CREPP-PLOEMEUR/Cocci-Bot/.img/img.png

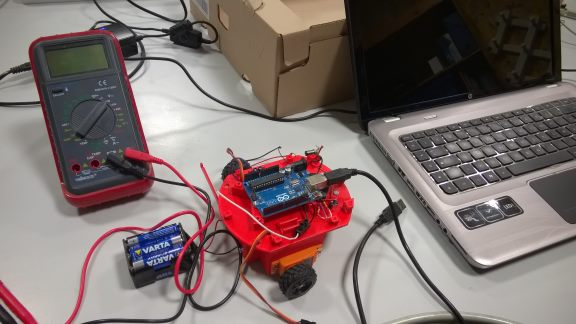
.img/img.png
