CREPP-PLOEMEUR/Cocci-Bot/Images/IMG_20151218_171229.jpg

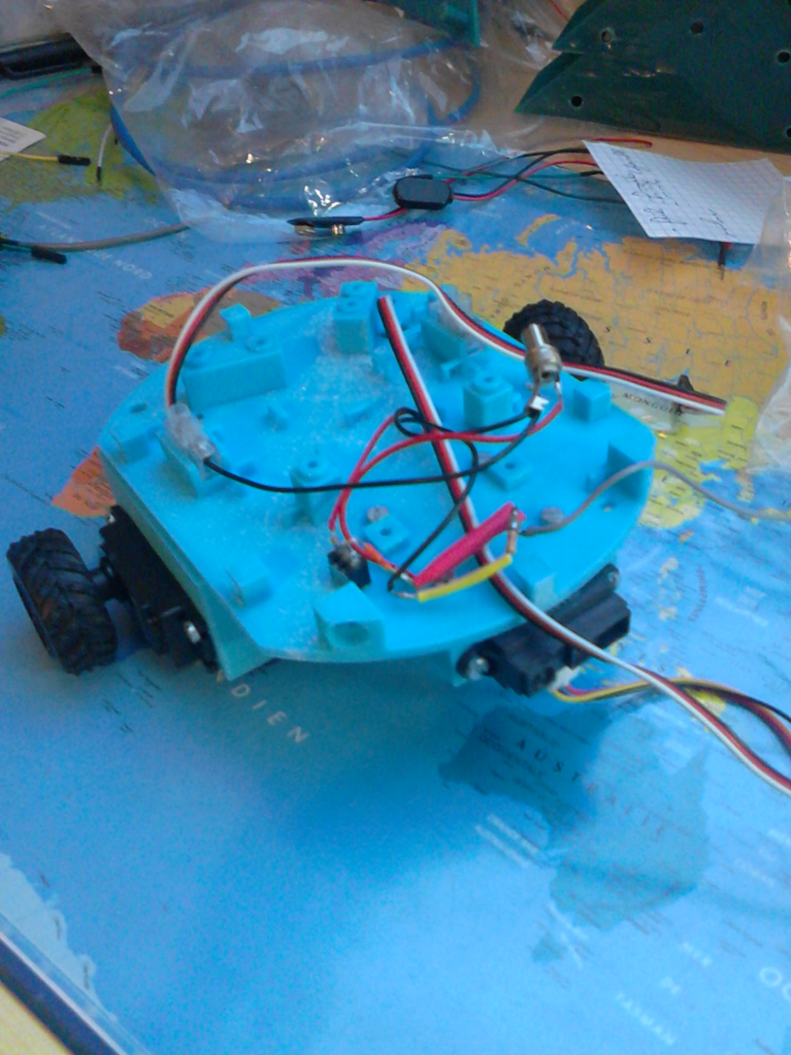
Images/IMG_20151218_171229.jpg
