CREPP-PLOEMEUR/Cocci-Bot/Images/IMG_20151218_171238.jpg

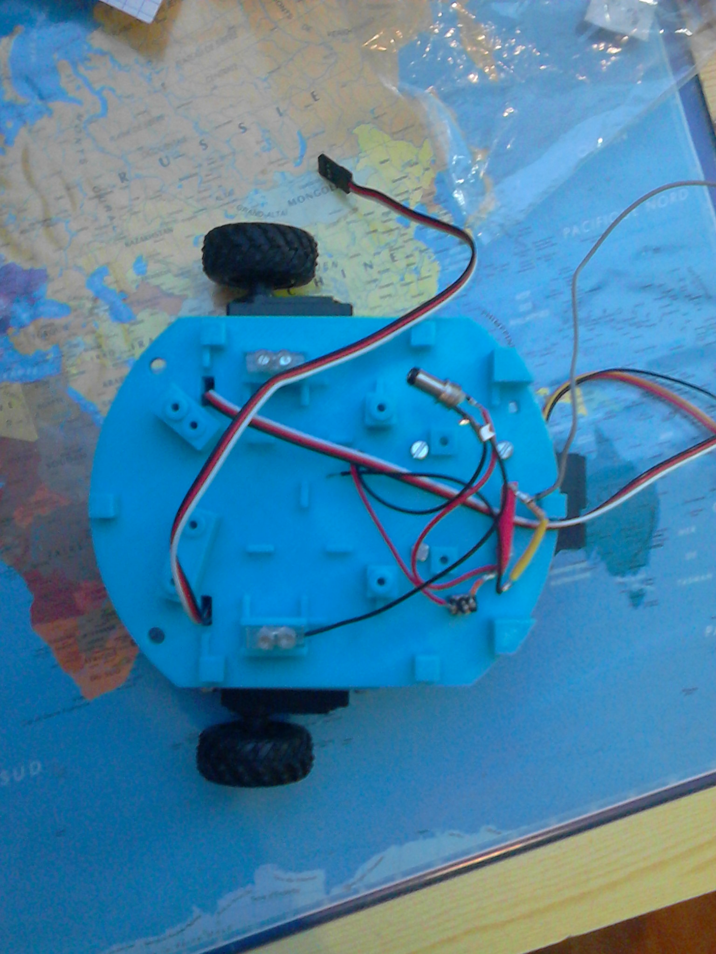
Images/IMG_20151218_171238.jpg
