CREPP-PLOEMEUR/Cocci-Bot/Images/IMG_20151218_171258.jpg

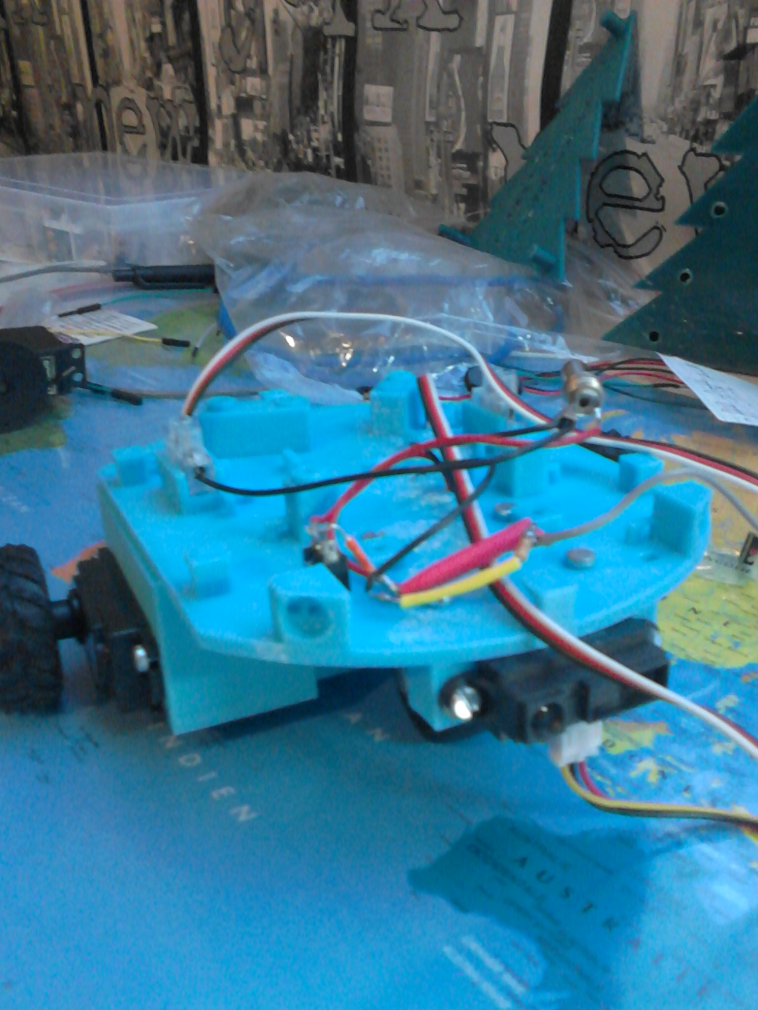
Images/IMG_20151218_171258.jpg
