CREPP-PLOEMEUR/Cocci-Bot/Images/IMG_20151218_171326.jpg

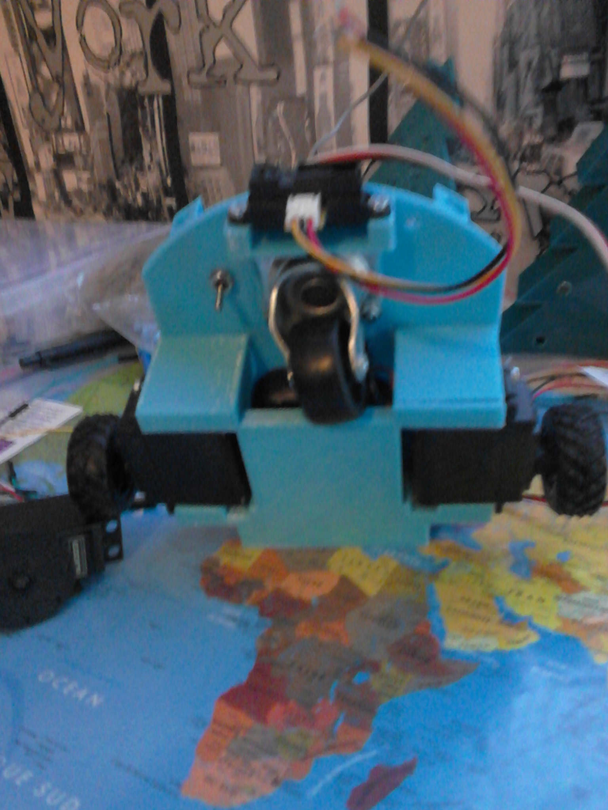
Images/IMG_20151218_171326.jpg
