CREPP-PLOEMEUR/Cocci-Bot/Images/IMG_20151218_171329.jpg

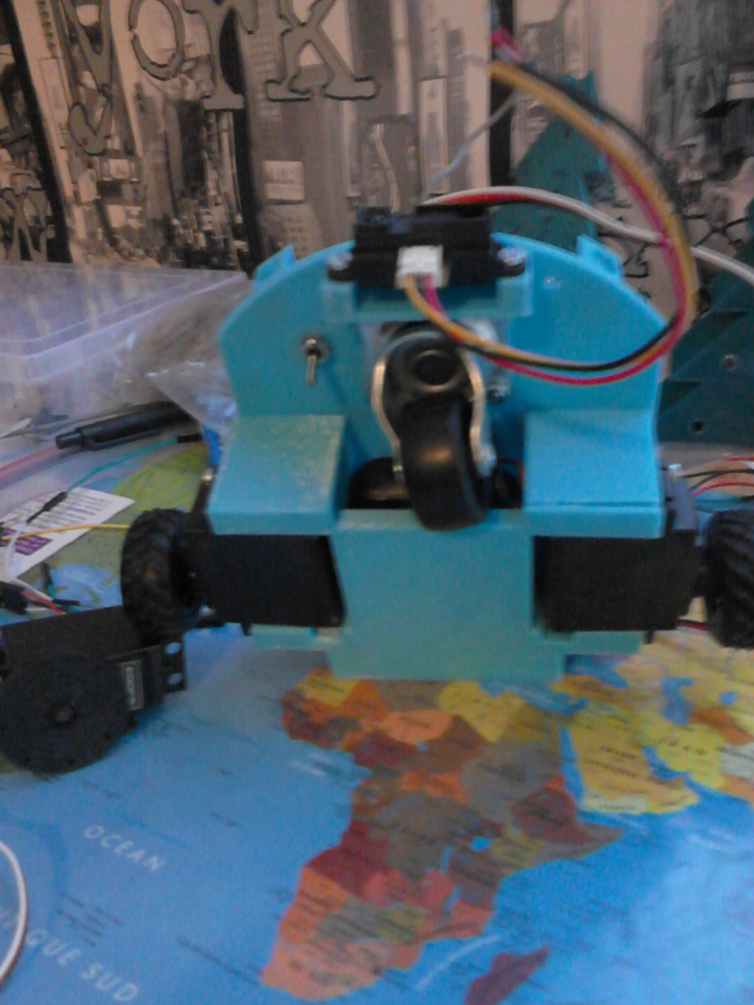
Images/IMG_20151218_171329.jpg
