CREPP-PLOEMEUR/Cocci-Bot/Images/Plateforme LCD et l'afficheur.JPG

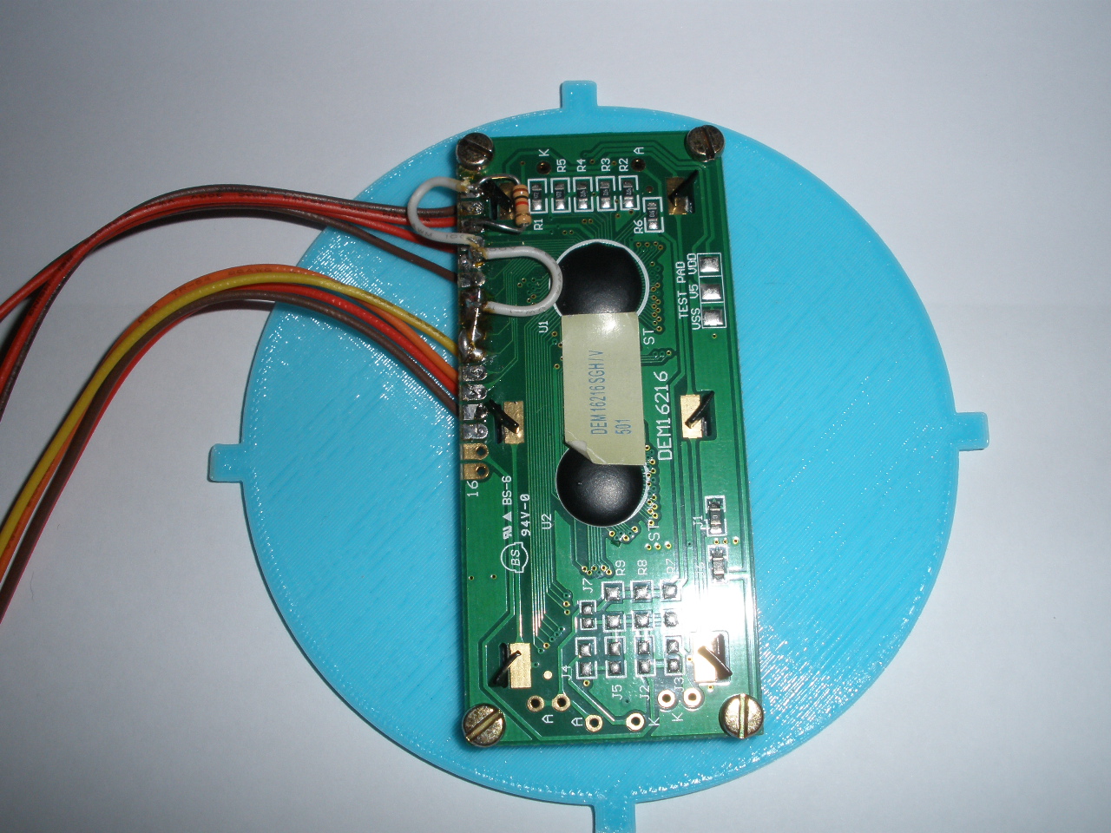
Images/Plateforme LCD et l'afficheur.JPG
