CREPP-PLOEMEUR/Cocci-Bot/Images/Vue arrière rôle de la barrette.JPG

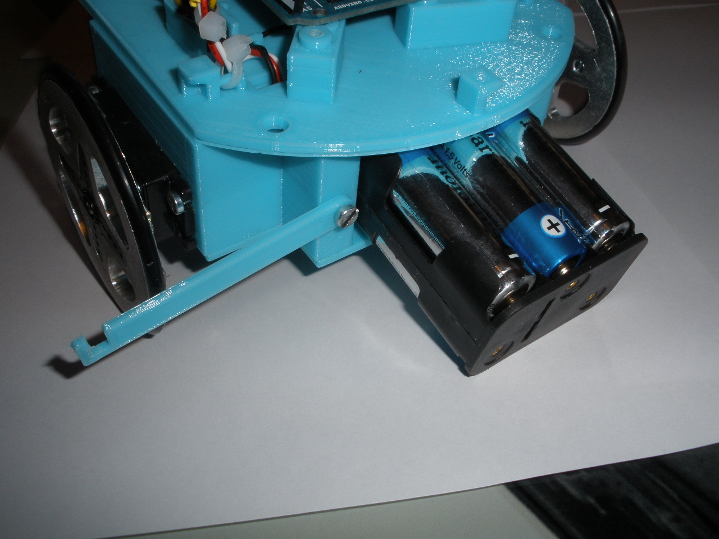
Images/Vue arrière rôle de la barrette.JPG
