CREPP-PLOEMEUR/Cocci-Bot/Images/Vue avant cocci bot.JPG

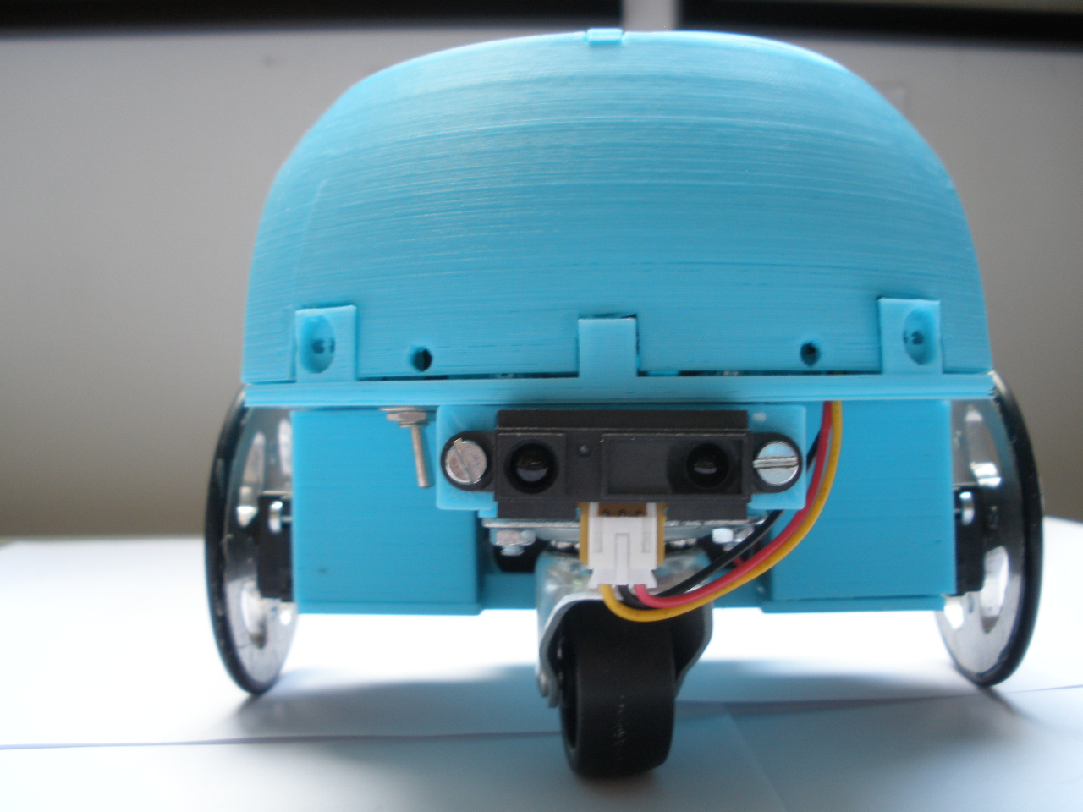
Images/Vue avant cocci bot.JPG
