CREPP-PLOEMEUR/Cocci-Bot/Images/Vue de dessus  sans coupole avec carte Arduino.JPG

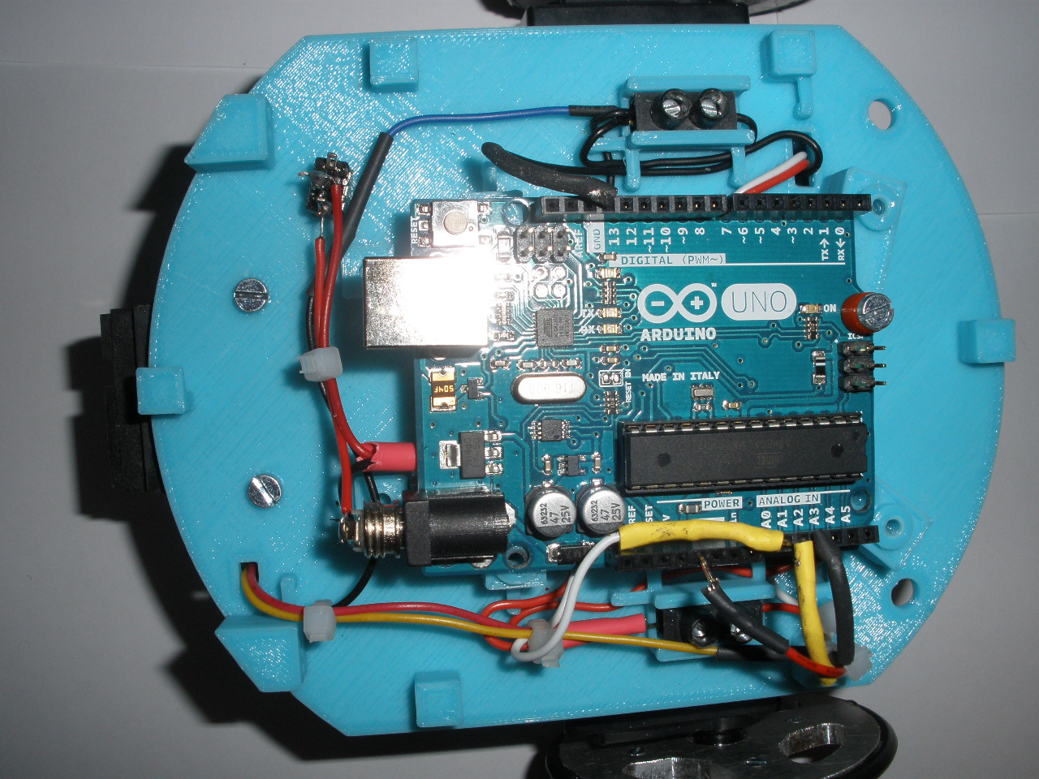
Images/Vue de dessus sans coupole avec carte Arduino.JPG
