CREPP-PLOEMEUR/Cocci-Bot/Images/Vue de dessus du cocci bot.JPG

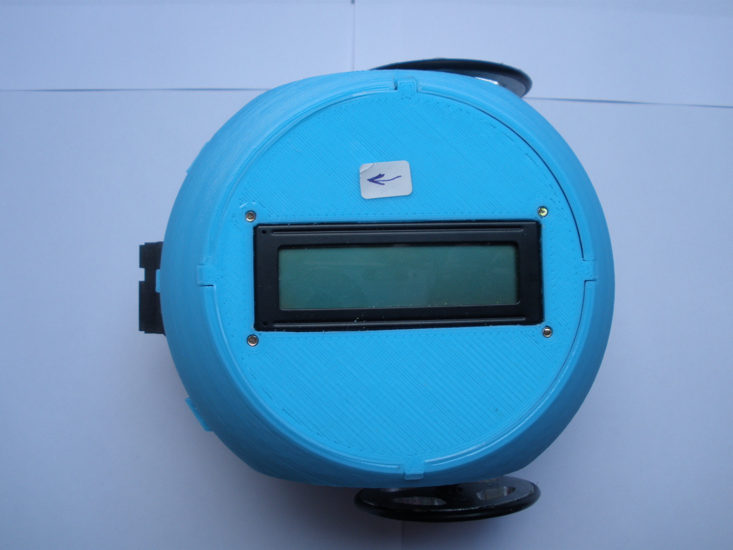
Images/Vue de dessus du cocci bot.JPG
