CREPP-PLOEMEUR/Cocci-Bot/Images/Vue fixation servo-roulette-capteur.JPG

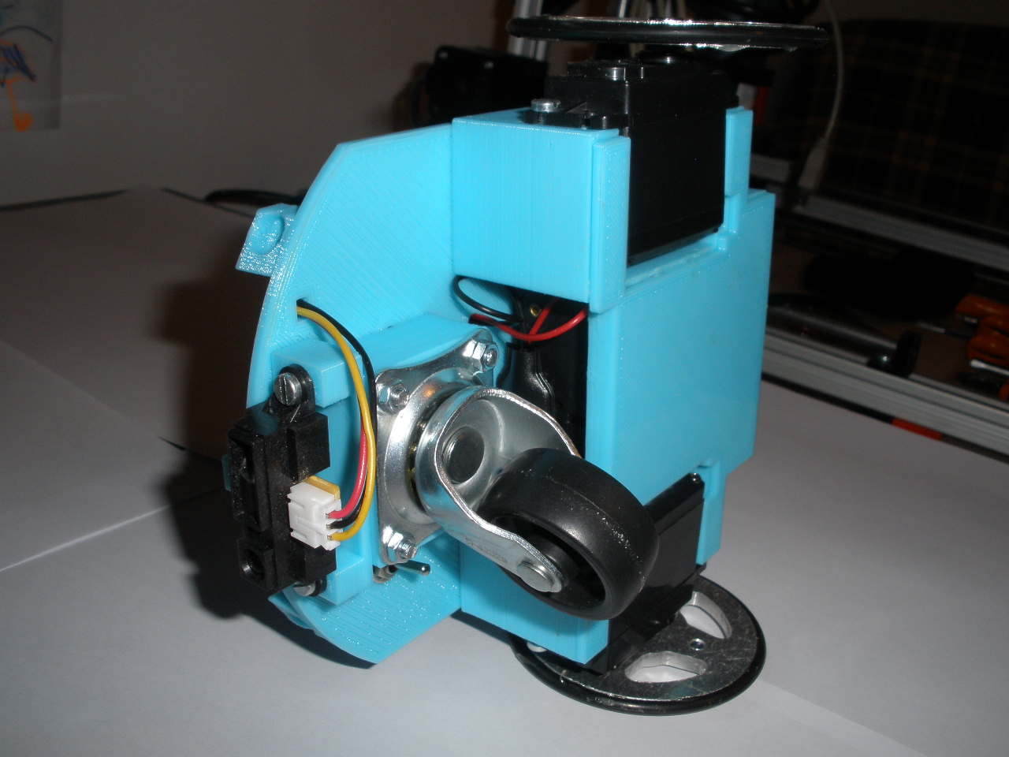
Images/Vue fixation servo-roulette-capteur.JPG
