CREPP-PLOEMEUR/Cocci-Bot/Fichiers STL/portepile12-15.stl

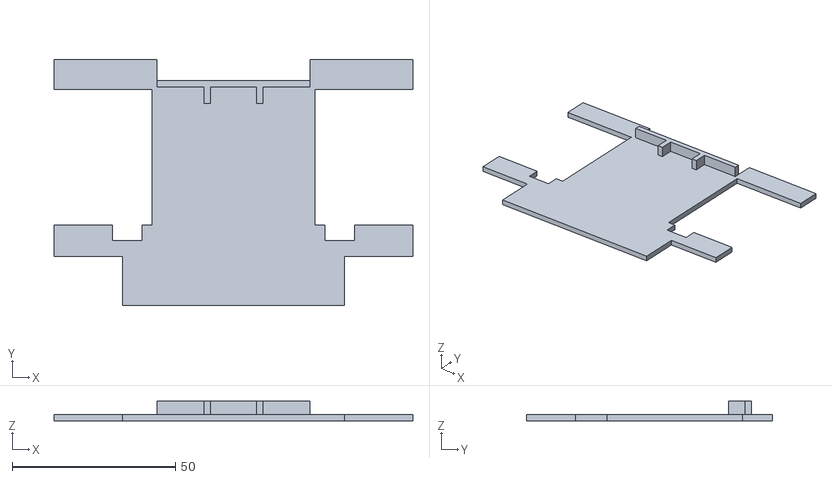
[picture p21: CAD file, 2022-04-02]
Fichiers STL/portepile12-15.stl
110.0 x 75.5 x 6.00
