CREPP-PLOEMEUR/Cocci-Bot/Fichiers STL/capteurdis12-15.stl

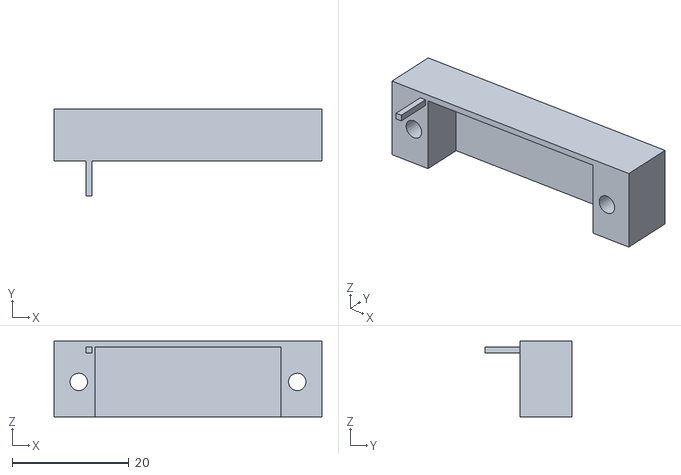
[picture p22: CAD file, 2022-04-02]
Fichiers STL/capteurdis12-15.stl
46.0 x 15.0 x 13.0
