CREPP-PLOEMEUR/Cocci-Bot/Fichiers STL/ServoG12-15.stl

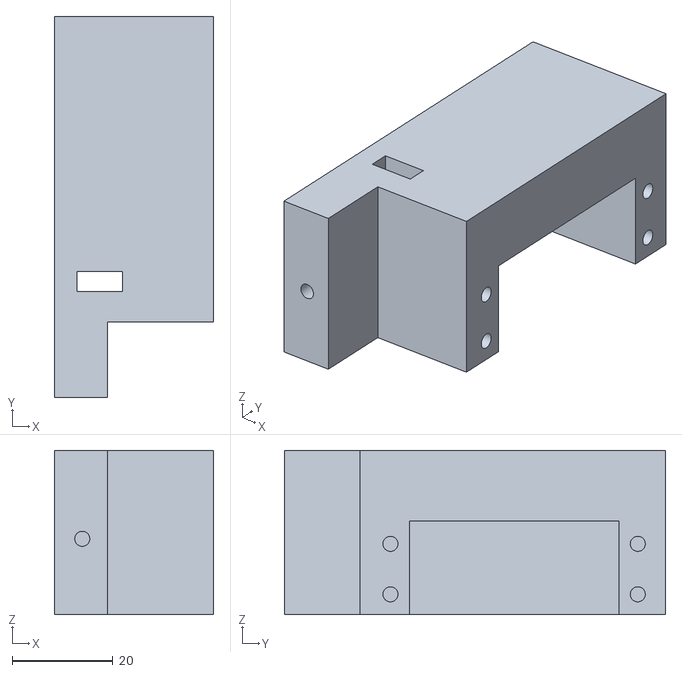
[picture p23: CAD file, 2022-04-02]
Fichiers STL/ServoG12-15.stl
31.5 x 75.5 x 32.5
