CREPP-PLOEMEUR/Cocci-Bot/Fichiers STL/coque12-15.stl

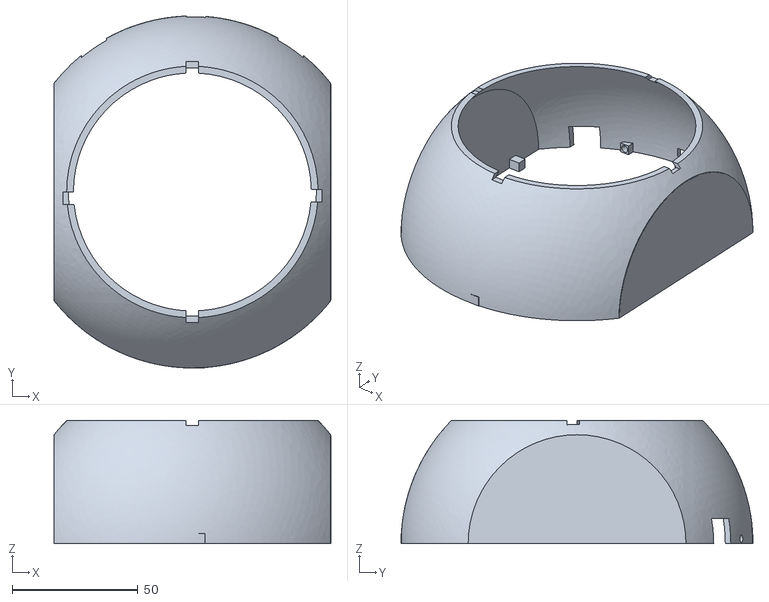
[picture p24: CAD file, 2022-04-02]
Fichiers STL/coque12-15.stl
110.1 x 140.0 x 49.0
