CREPP-PLOEMEUR/Cocci-Bot/Fichiers STL/Hausseroulette15mm12-15.stl

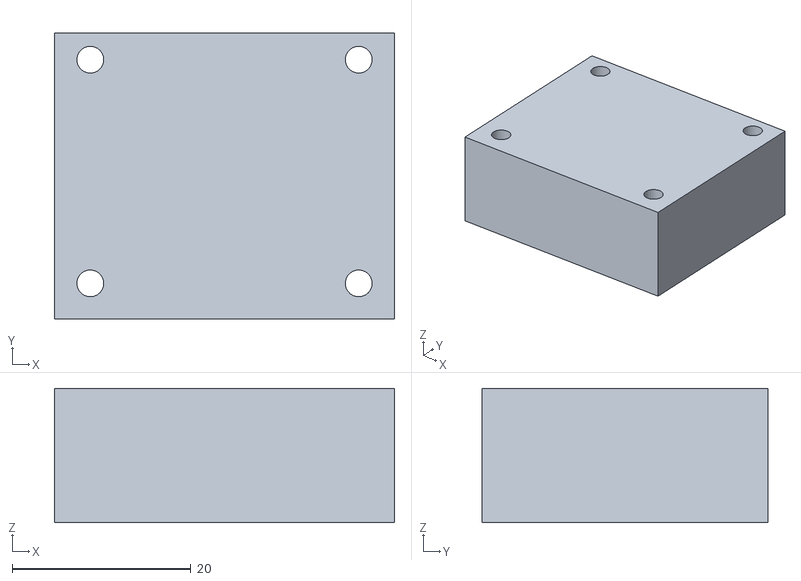
[picture p25: CAD file, 2022-04-02]
Fichiers STL/Hausseroulette15mm12-15.stl
38.0 x 32.0 x 15.0
