CREPP-PLOEMEUR/Cocci-Bot/Fichiers STL/plateforme12-15.stl

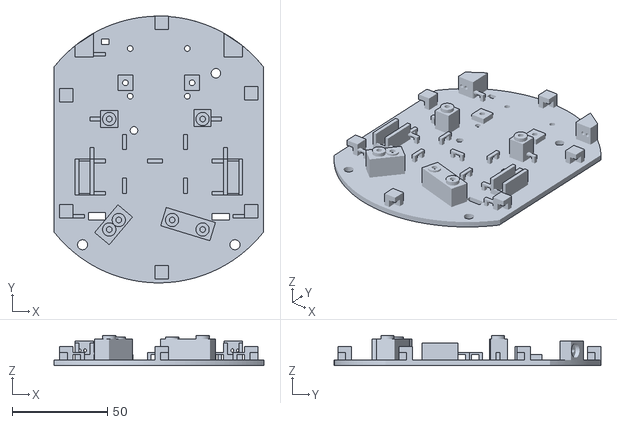
[picture p26: CAD file, 2022-04-02]
Fichiers STL/plateforme12-15.stl
110.2 x 140.0 x 16.0
