CREPP-PLOEMEUR/Cocci-Bot/Fichiers STL/Hausseroulette2mm12-15.stl

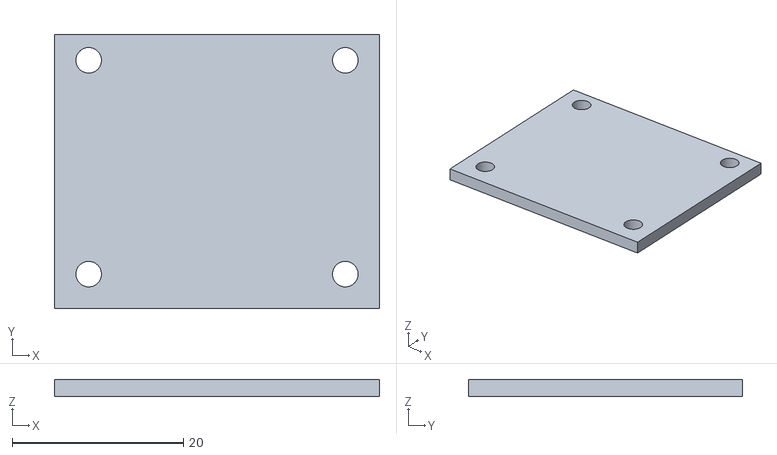
[picture p27: CAD file, 2022-04-02]
Fichiers STL/Hausseroulette2mm12-15.stl
38.0 x 32.0 x 2.00
