CREPP-PLOEMEUR/Cocci-Bot/Fichiers STL/coccibot12-15.fcstd

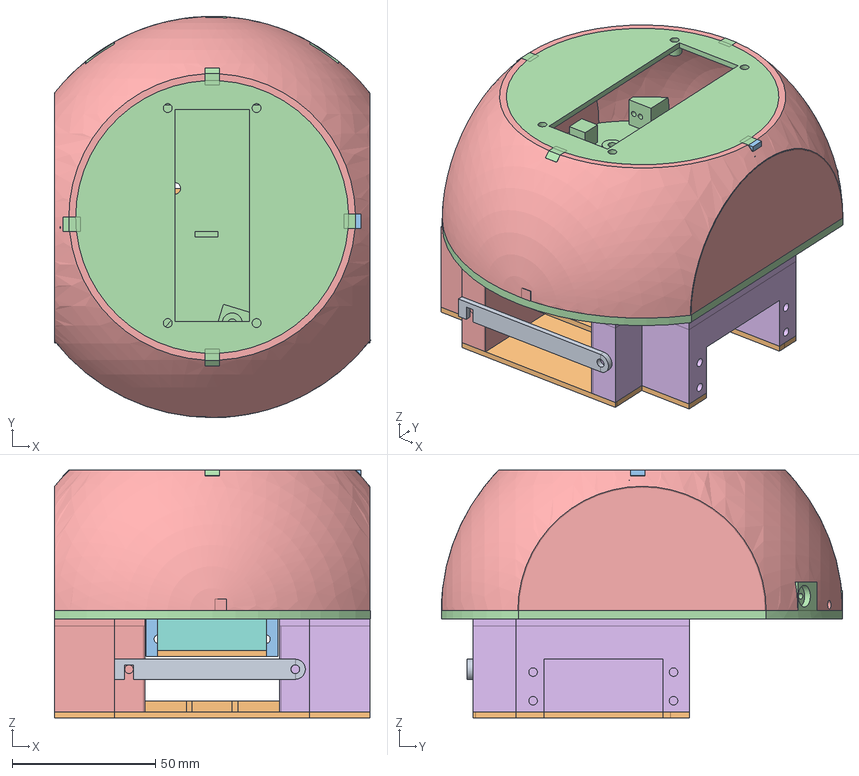
[picture p28: CAD file, 2022-04-02]
Fichiers STL/coccibot12-15.fcstd
110.2 x 140.0 x 86.5 mm
barretteOK
portepile
capteurD
plateforme
Servodroit1
ServoGauche
Renfortlat1
hausseroulette15mm
Renfortlat002
hausseroulette2mm
PlatineLCD
Coquefinal
