CREPP-PLOEMEUR/Cocci-Bot/Fichiers STL/platineLCD12-15.stl

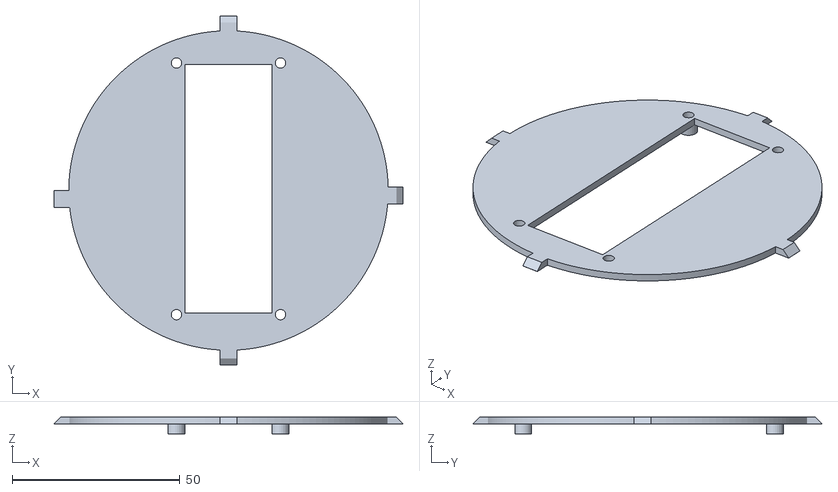
[picture p29: CAD file, 2022-04-02]
Fichiers STL/platineLCD12-15.stl
104.0 x 104.0 x 5.00
