CREPP-PLOEMEUR/Cocci-Bot/Fichiers STL/barette12-15.stl

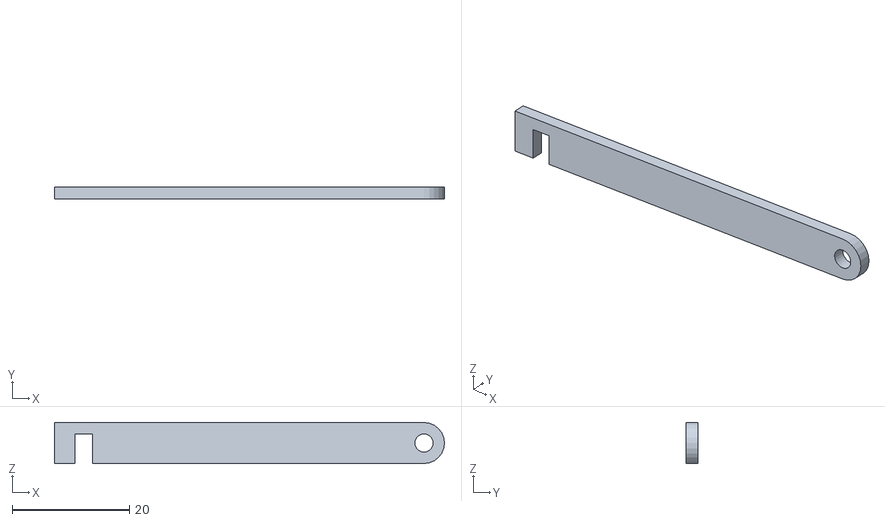
[picture p30: CAD file, 2022-04-02]
Fichiers STL/barette12-15.stl
66.5 x 2.00 x 7.00
