CREPP-PLOEMEUR/Cocci-Bot/(list of files, cad)

Other CAD files:
Fichiers STL/servoD12-15.stl
