CREPP-PLOEMEUR/Cocci-Bot/Instructions/Montage Cocci bot p1.PDF

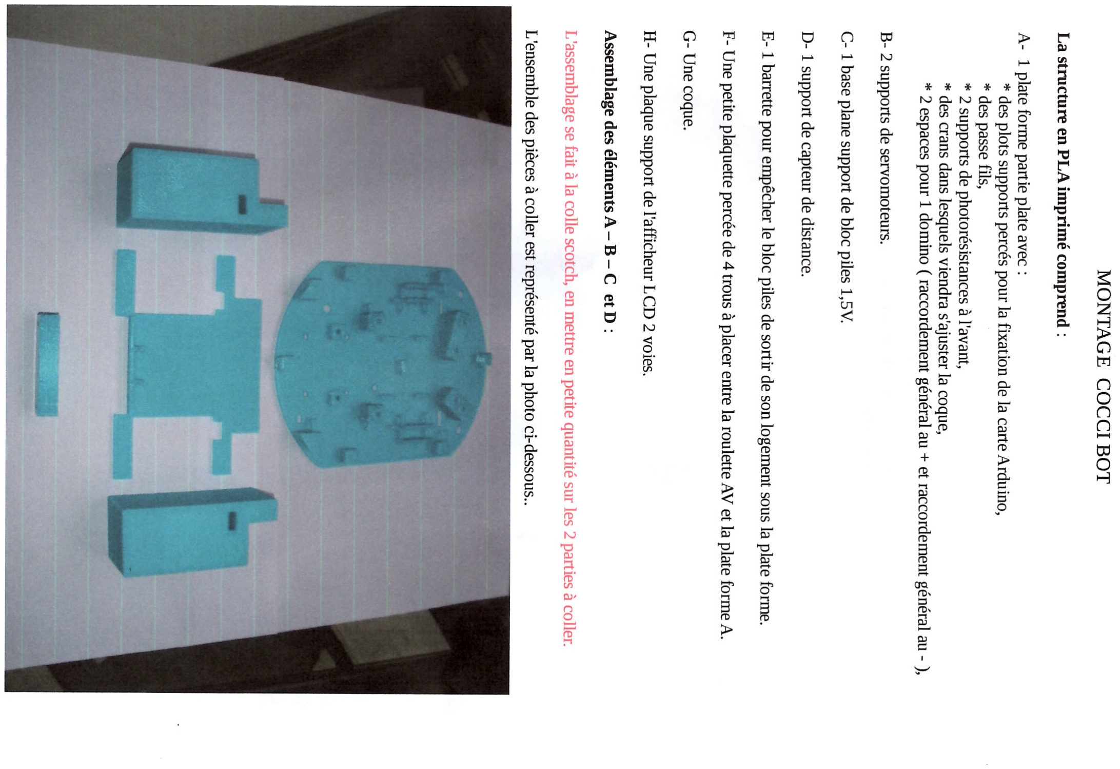
[picture p31: page 1]
