CREPP-PLOEMEUR/Cocci-Bot/Instructions/Montage Cocci bot p2.PDF

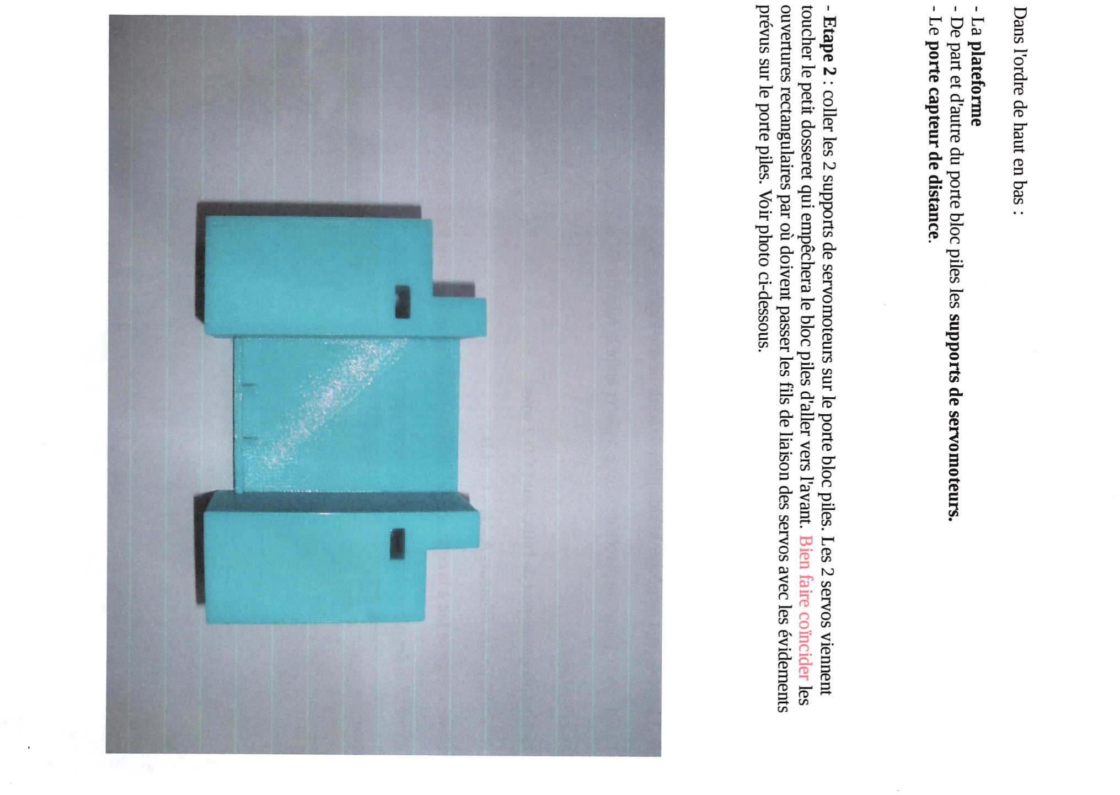
[picture p32: page 1]
