CREPP-PLOEMEUR/Cocci-Bot/Instructions/Montage Cocci bot p3.PDF

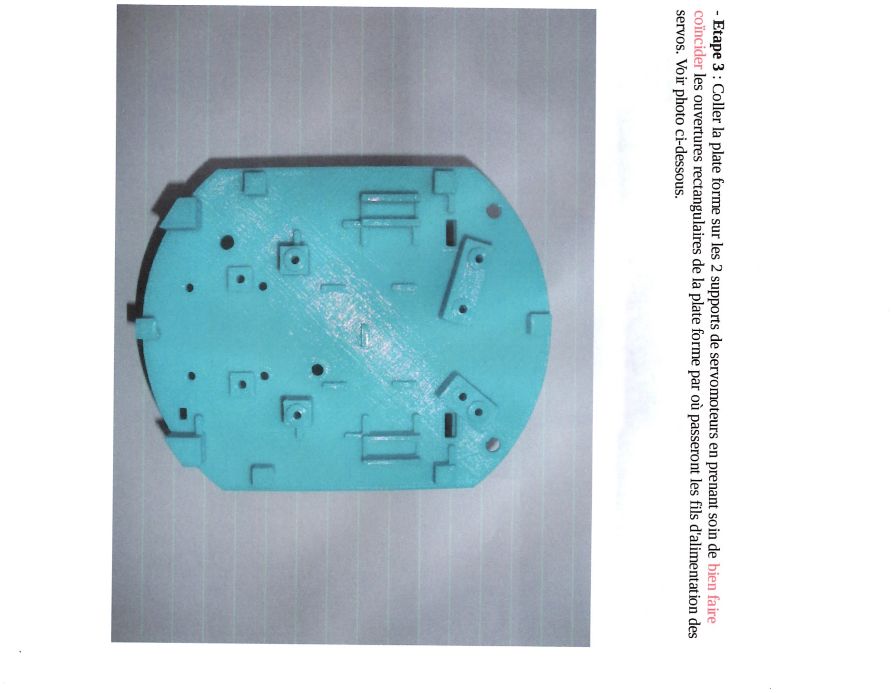
[picture p33: page 1]
