CREPP-PLOEMEUR/Cocci-Bot/Instructions/Montage Cocci bot p4.PDF

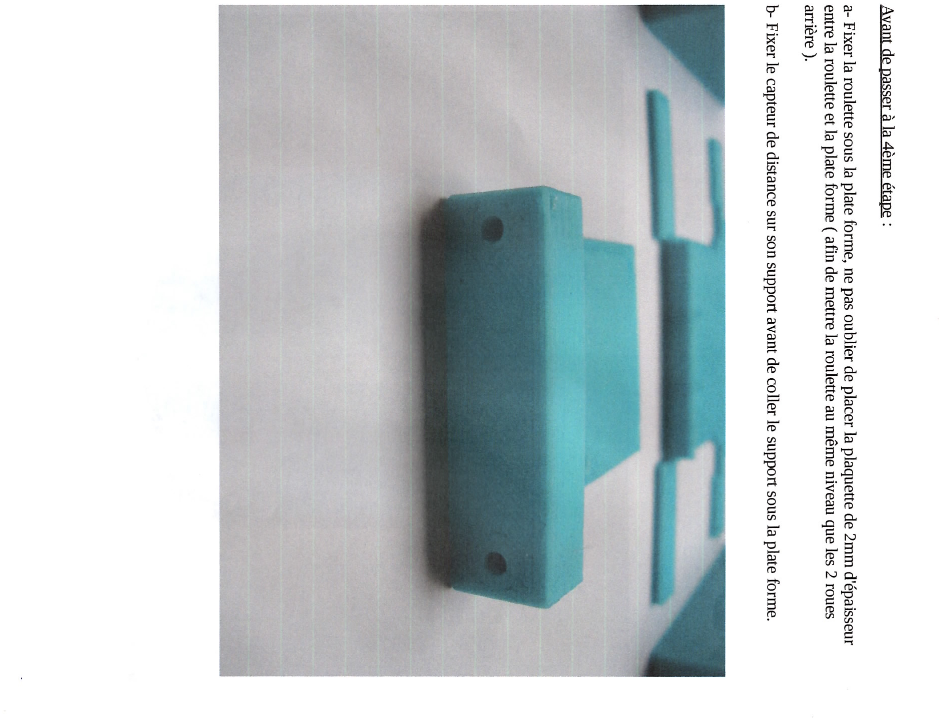
[picture p34: page 1]
