CREPP-PLOEMEUR/Cocci-Bot/Instructions/Montage Cocci bot p5.PDF

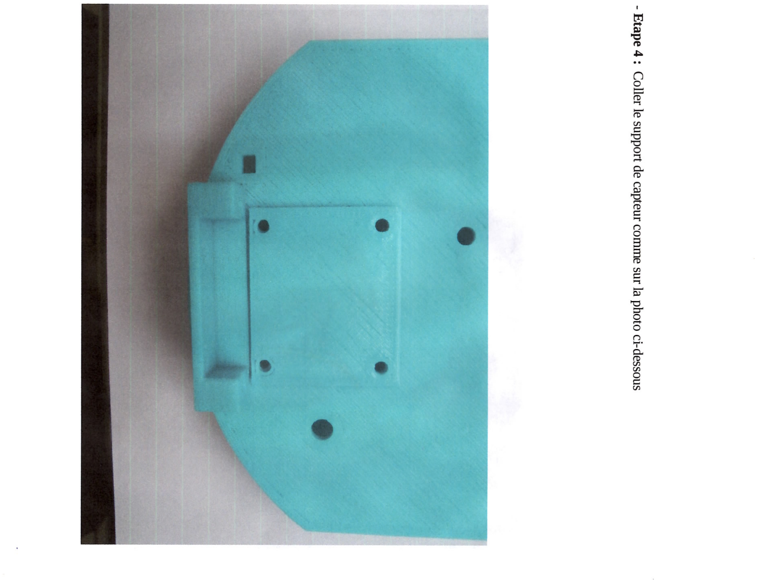
[picture p35: page 1]
