CREPP-PLOEMEUR/Cocci-Bot/Instructions/Montage Cocci bot p6.PDF

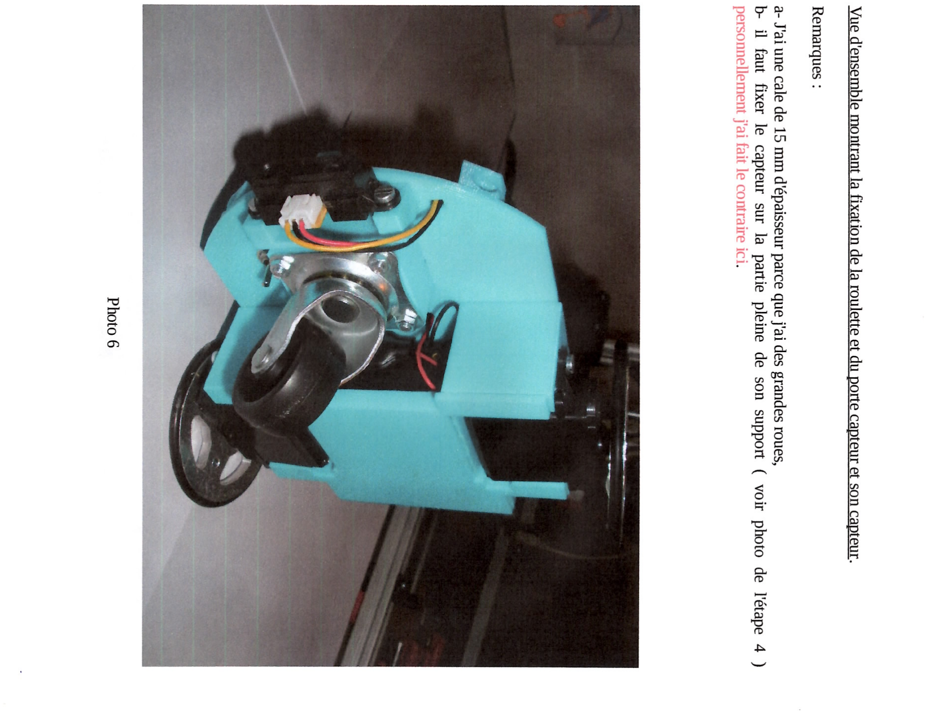
[picture p36: page 1]
