CREPP-PLOEMEUR/Cocci-Bot/Instructions/Montage Cocci bot p7.PDF

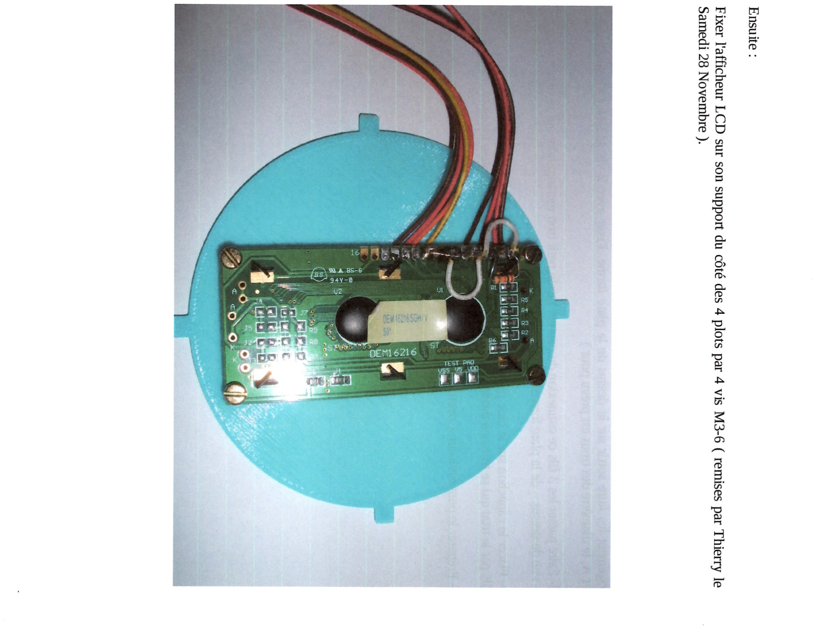
[picture p37: page 1]
