CREPP-PLOEMEUR/Cocci-Bot/Instructions/Montage Cocci bot p8.PDF

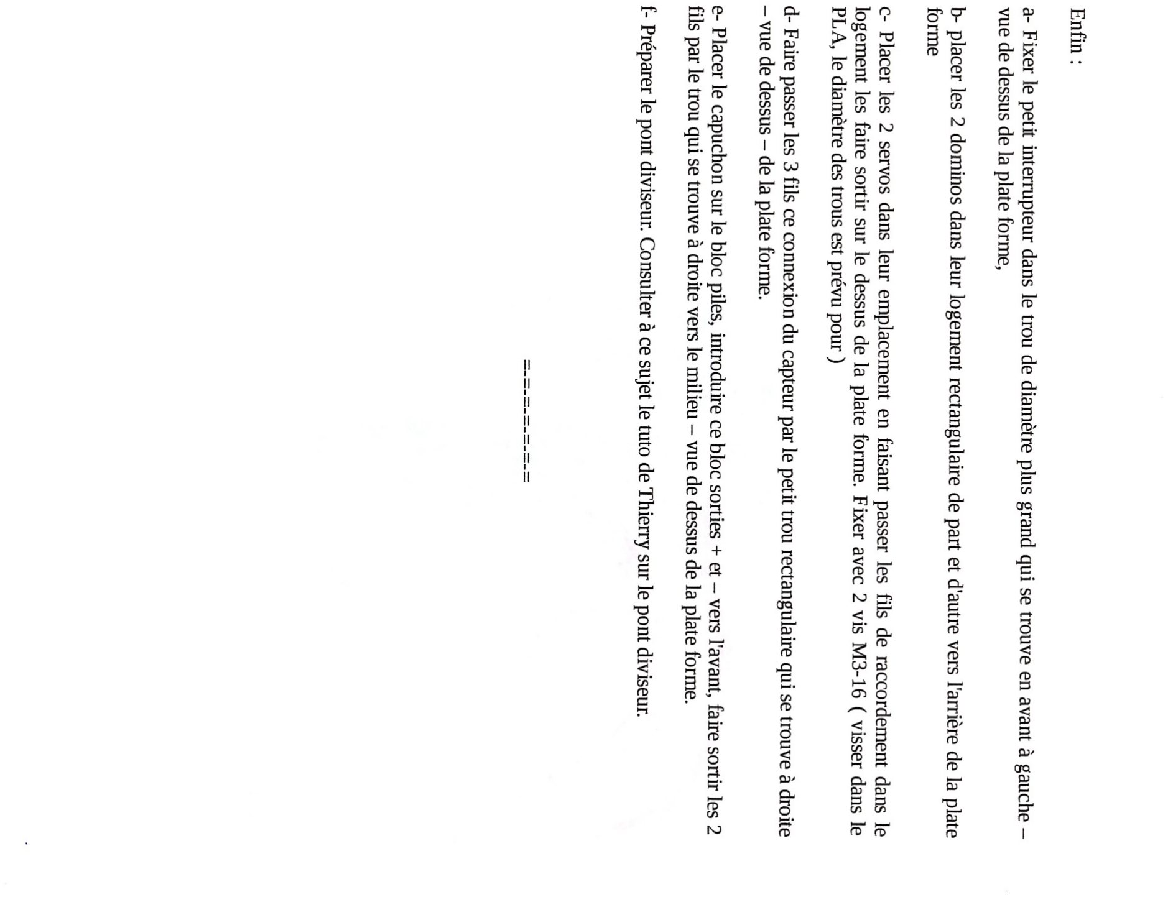
[picture p38: page 1]
