CREPP-PLOEMEUR/Cocci-Bot/Instructions/Montage pont diviseur p1.PDF

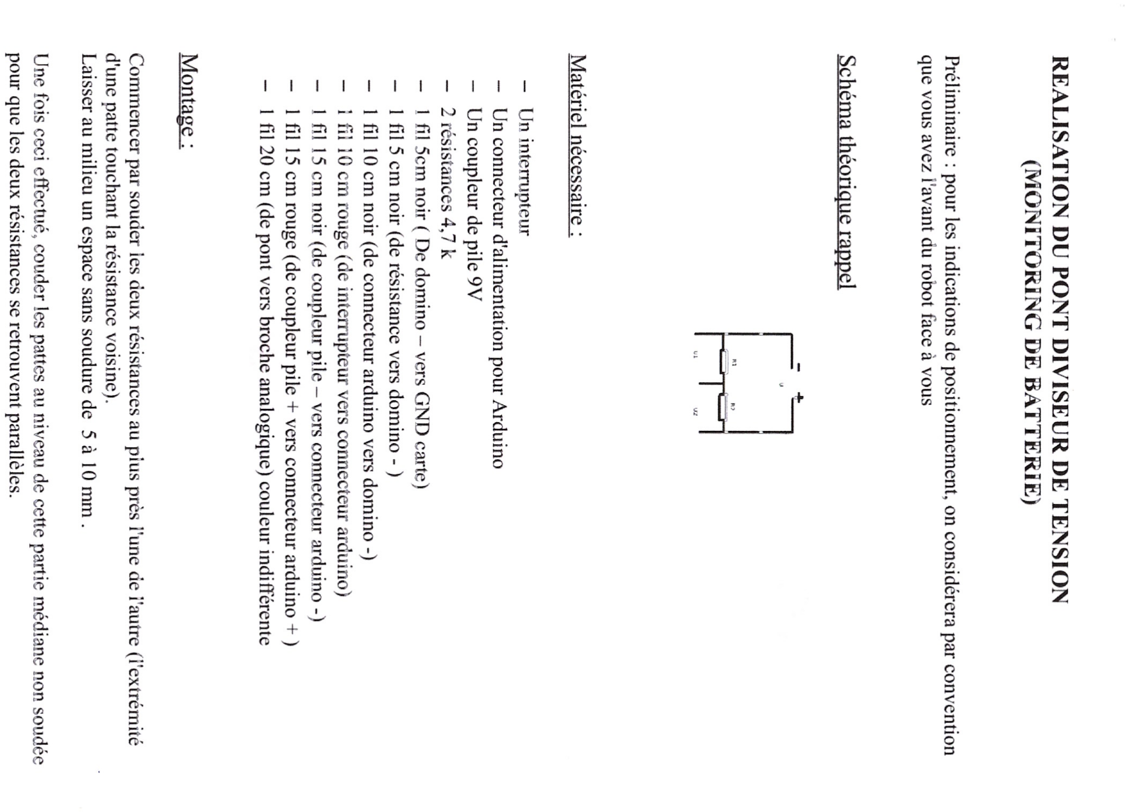
[picture p39: page 1]
