CREPP-PLOEMEUR/Cocci-Bot/Instructions/Montage pont diviseur p2.PDF

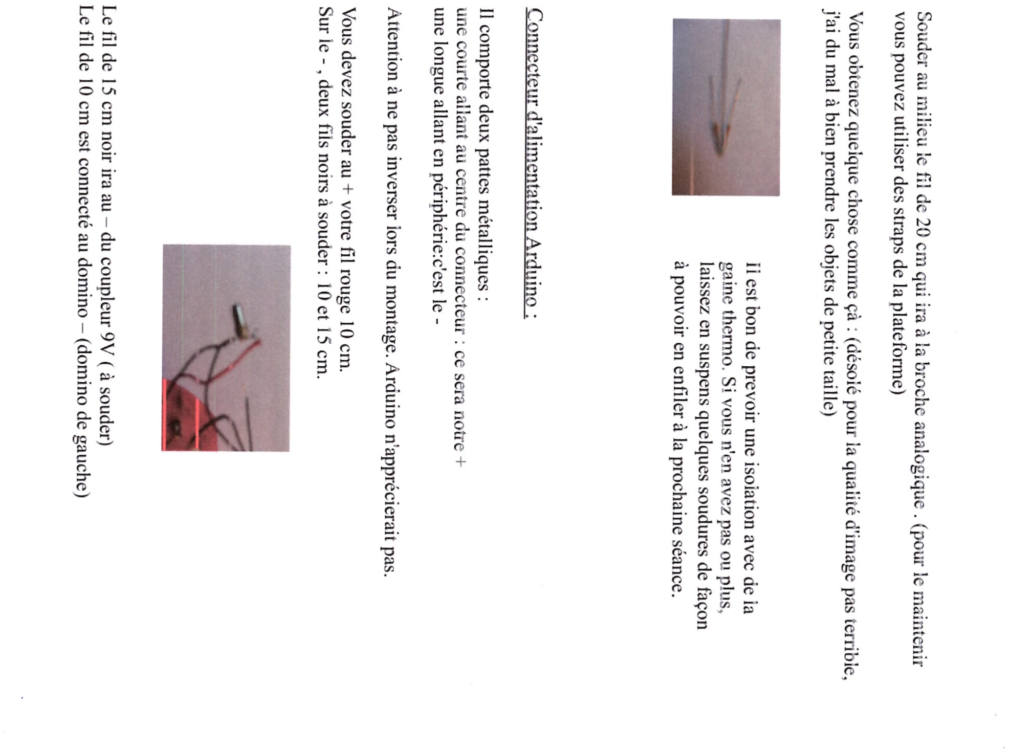
[picture p40: page 1]
