CREPP-PLOEMEUR/Cocci-Bot/Instructions/Montage pont divisuer p3.PDF

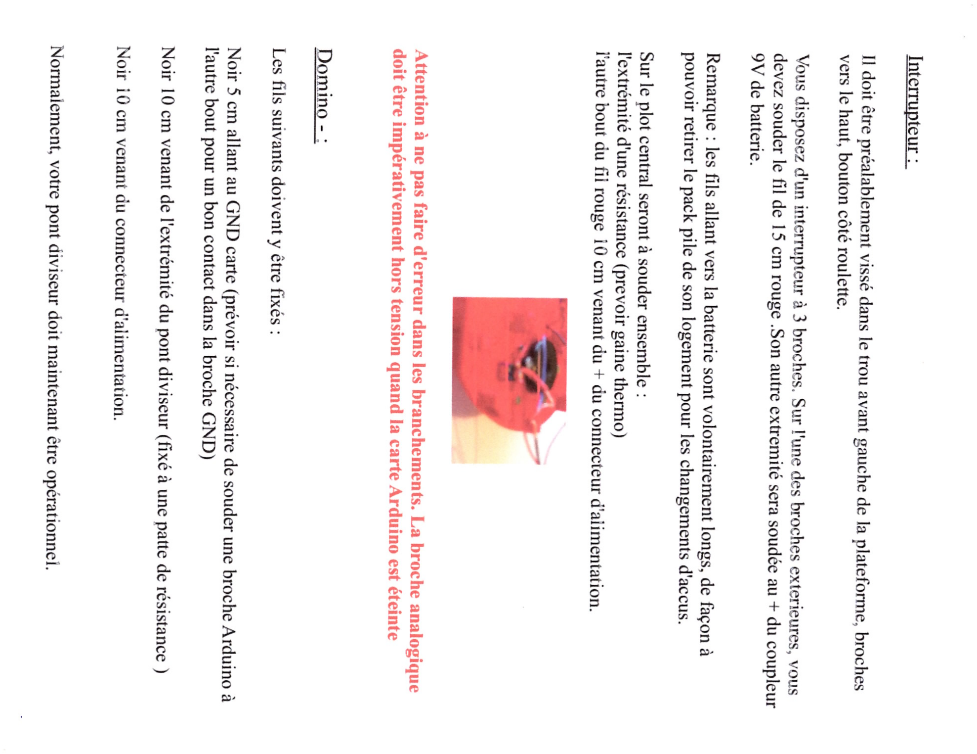
[picture p41: page 1]
