CREPP-PLOEMEUR/Cocci-Bot/Instructions/Eléments de structure à coller/Etape 1 les 5 éléments à coller.JPG

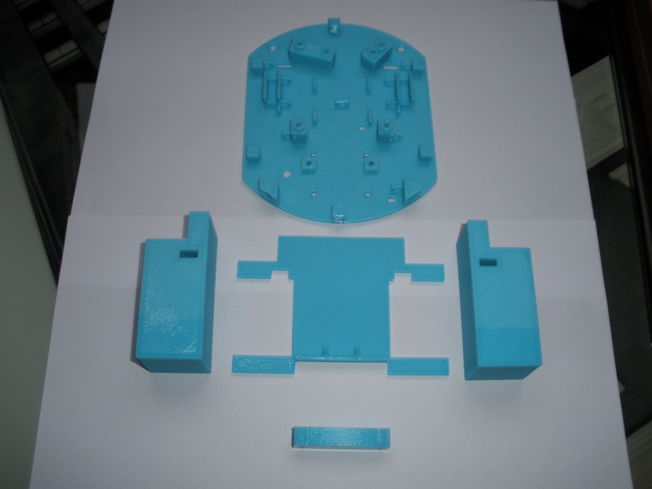
Instructions/Eléments de structure à coller/Etape 1 les 5 éléments à coller.JPG
