CREPP-PLOEMEUR/Cocci-Bot/Instructions/Eléments de structure à coller/Etape 2 supports servos sur porte piles.JPG

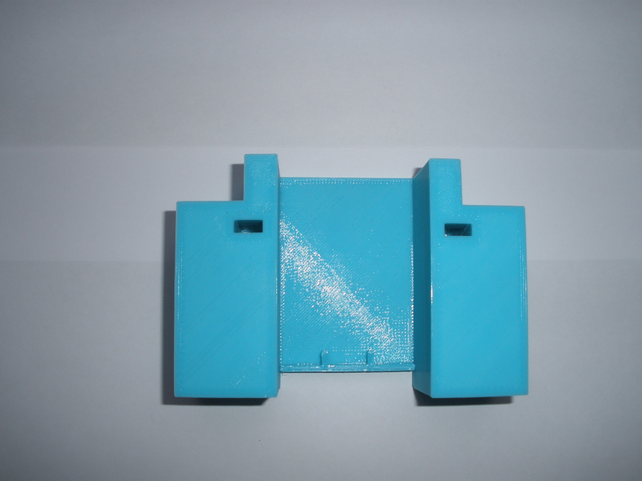
Instructions/Eléments de structure à coller/Etape 2 supports servos sur porte piles.JPG
