CREPP-PLOEMEUR/Cocci-Bot/Instructions/Eléments de structure à coller/Etape 3 coller la plate forme sur les supports de servos.JPG

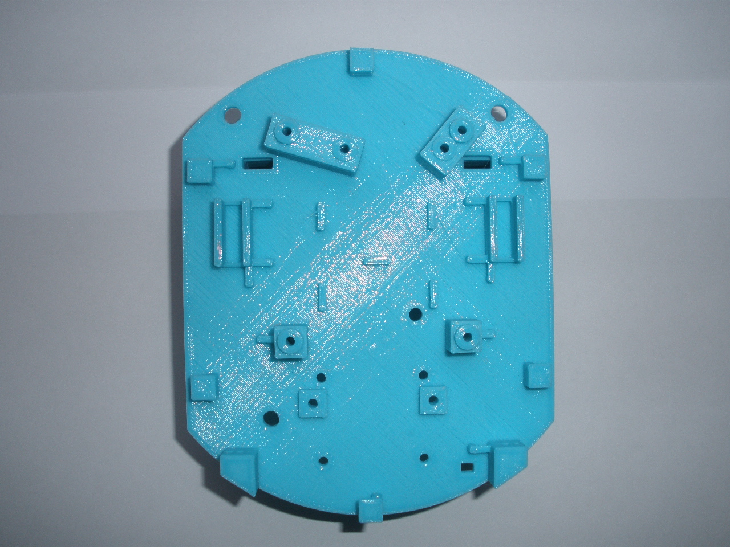
Instructions/Eléments de structure à coller/Etape 3 coller la plate forme sur les supports de servos.JPG
