CREPP-PLOEMEUR/Cocci-Bot/Instructions/Eléments de structure à coller/Etape 4  porte capteur de distance.JPG

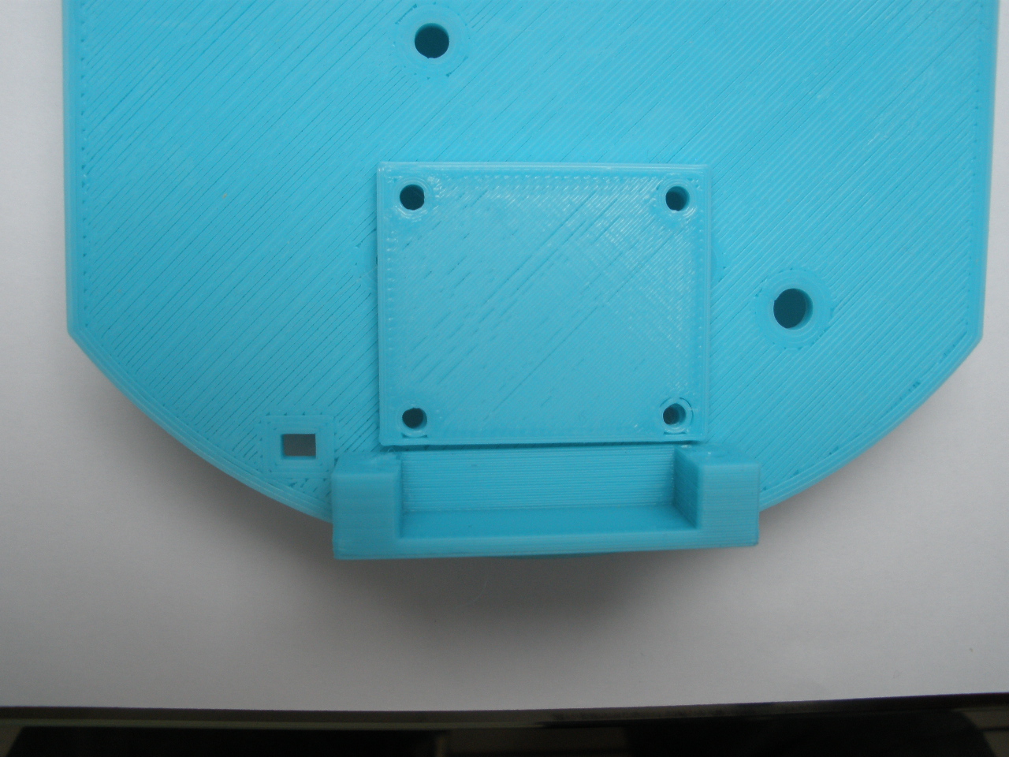
Instructions/Eléments de structure à coller/Etape 4 porte capteur de distance.JPG
