CREPP-PLOEMEUR/Cocci-Bot/Instructions/Eléments de structure à coller/Le porte capteur de distance.JPG

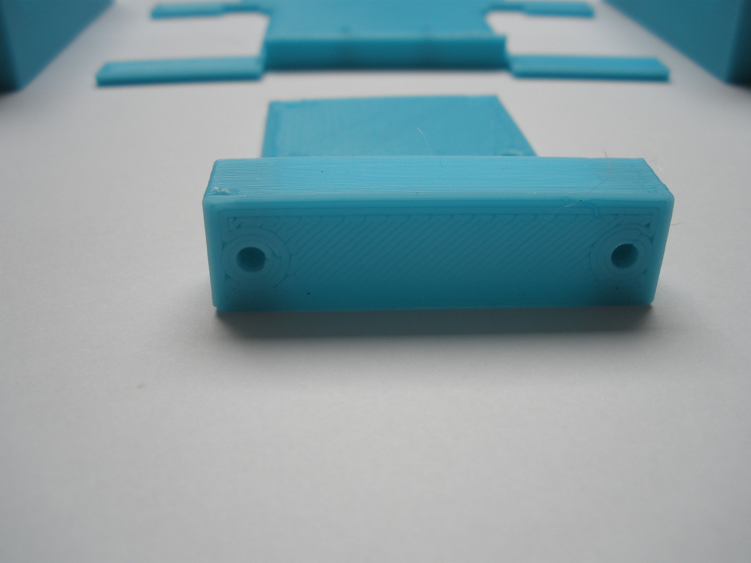
Instructions/Eléments de structure à coller/Le porte capteur de distance.JPG
