CREPP-PLOEMEUR/Cocci-Bot/Instructions/Eléments de structure à coller/Vue montrant la position du support de servo.JPG

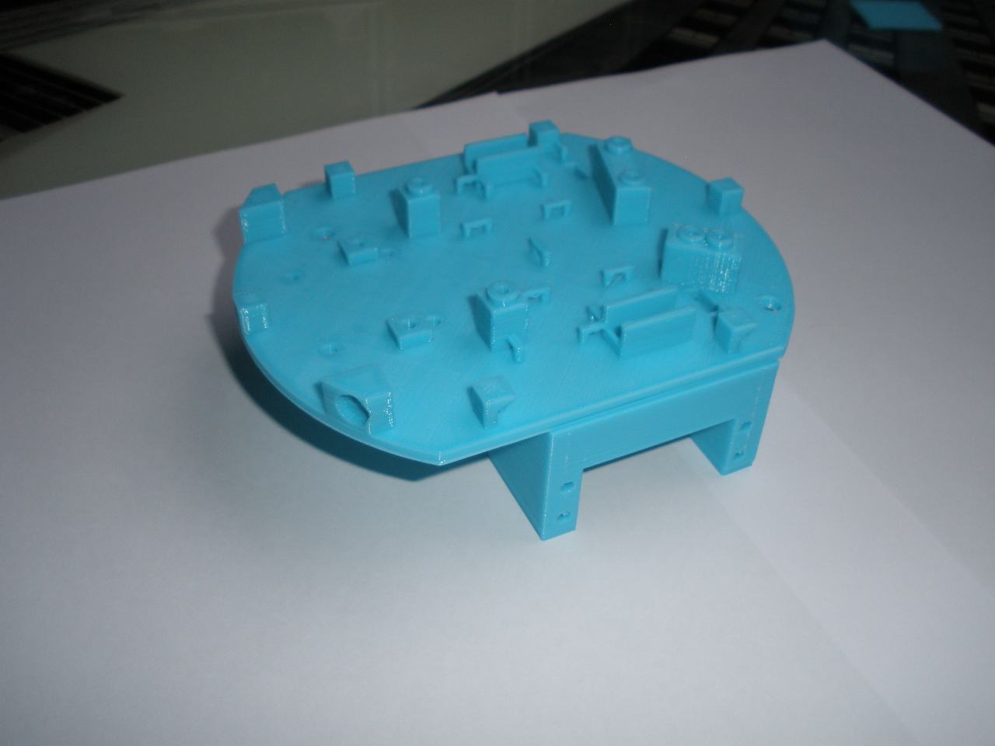
Instructions/Eléments de structure à coller/Vue montrant la position du support de servo.JPG
